soggybag/Trem-SMD/archive/v2.1/README.md

# Trem SMD v2.1: archived revision

- **Git tag:** `v2.1` (commit `e5894ea`, 2026-10-18)
- **Tag note:** v2.1: symmetric VCA balance trim (RV4 3314J 2k), fab files generated 2026-10-18
- **Archived:** 2026-10-18 with `_tools/archive_version.py`

## Finding a part

1. Open `Trem_23_ibom.html` in a browser. Type a reference (R14) or a value (100k) in the filter box; the part lights up on the board.
   - Hover over a pad to see its net.
   - F / B switch sides.
2. Find the same reference in `Trem_23_schematic.pdf` with Cmd-F.
3. `Trem_23_board_front.pdf` / `_back.pdf` are printable: page 1 has the outlines and references, page 2 the copper. The back is mirrored, as you see it holding the board.

## Files

- `Trem_23_board_back.pdf`
- `Trem_23_board_front.pdf`
- `Trem_23_ibom.html`
- `Trem_23_render_bottom.png`
- `Trem_23_render_top.png`
- `Trem_23_schematic.pdf`
- `docs`/
- `parts.csv`
- `production`/

`production/` holds the files sent to JLCPCB for this revision: Trem_23.zip, Trem_23_hand_solder.csv, bom.csv, designators.csv, netlist.ipc, positions.csv.
