soggybag/Trem-SMD/Trem_23_render_bottom.png

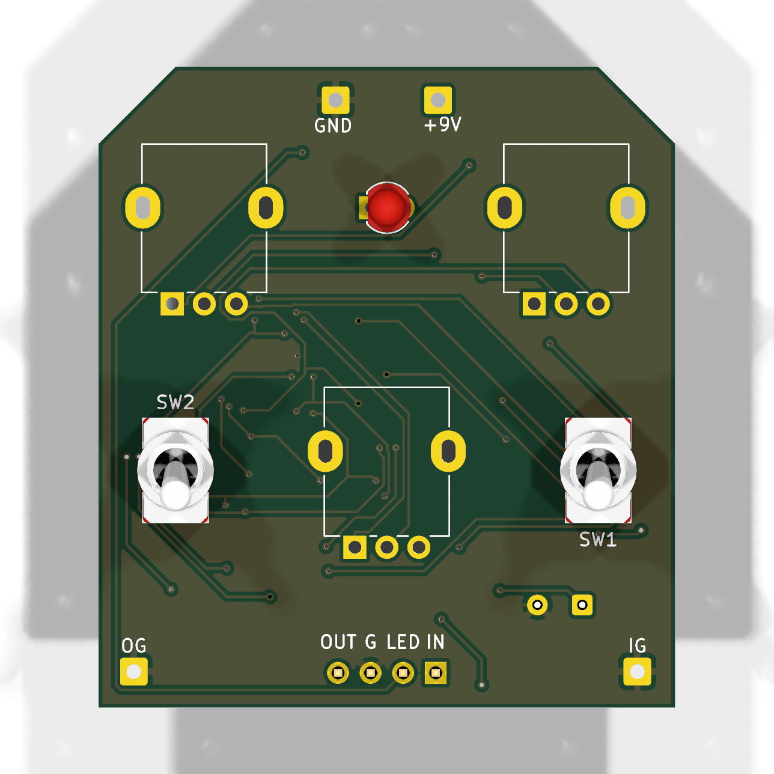
Trem_23_render_bottom.png
