soggybag/Trem-SMD/Trem_23_render_enclosure.png

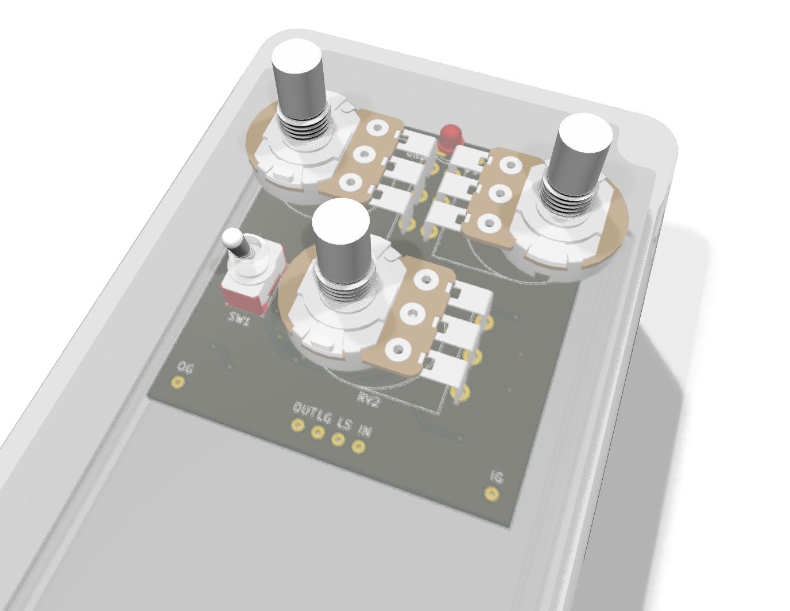
Trem_23_render_enclosure.png
