soggybag/Trem-SMD/Trem_23_render_enclosure_side.png

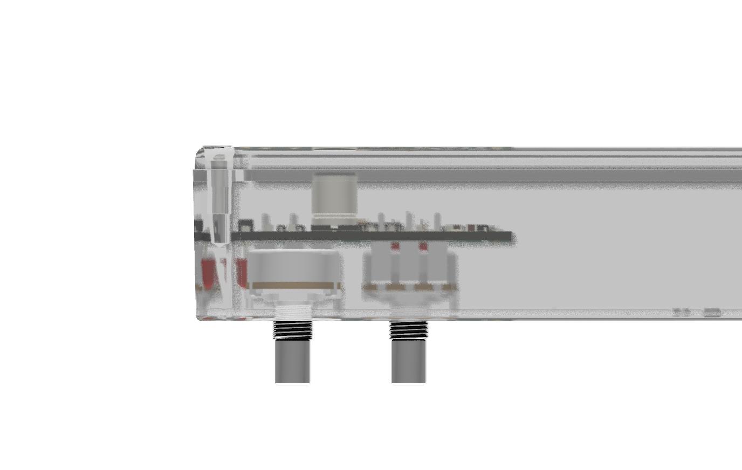
Trem_23_render_enclosure_side.png
