soggybag/Trem-SMD/Trem_23_render_side.png

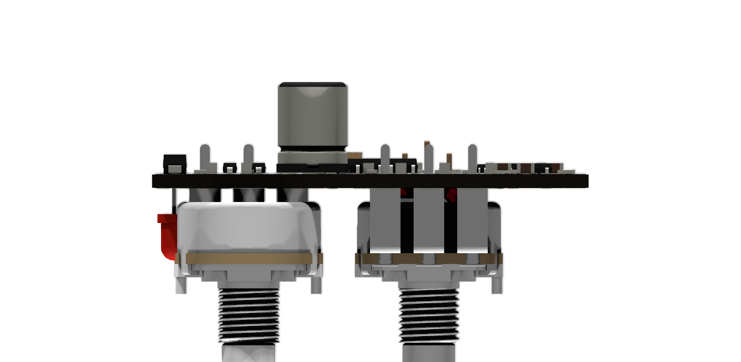
Trem_23_render_side.png
