soggybag/Trem-SMD/archive/v2.1/parts.csv

Reference | Value | Footprint | Side | X mm | Y mm | Rotation | LCSC | Fitted by
C1 | 10u | Capacitor_SMD:C_0805_2012Metric | front | 31.3 | 26.8 | 180.0 | C15850 | JLC
C2 | 100n | Capacitor_SMD:C_0805_2012Metric | front | 36.8 | 47.0 | 0.0 | C49678 | JLC
C3 | 470u | Capacitor_THT:CP_Radial_D8.0mm_P3.50mm | front | 28.25 | 62.0 | 0.0 | C970706 | hand
C4 | 100n | Capacitor_SMD:C_0805_2012Metric | front | 36.9 | 53.5 | 180.0 | C49678 | JLC
C5 | 10u | Capacitor_SMD:C_0805_2012Metric | front | 28.2 | 30.8 | 180.0 | C15850 | JLC
C6 | 10n | Capacitor_SMD:C_0805_2012Metric | front | 53.6 | 40.85 | 180.0 | C1710 | JLC
C7 | 1n | Capacitor_SMD:C_0805_2012Metric | front | 52.15 | 50.3 | 0.0 | C46653 | JLC
C8 | 220p | Capacitor_SMD:C_0805_2012Metric | front | 36.85 | 44.8 | 0.0 | C107145 | JLC
C9 | 1u | Capacitor_SMD:C_0805_2012Metric | front | 39.1 | 64.35 | 180.0 | C28323 | JLC
C10 | 220p | Capacitor_SMD:C_0805_2012Metric | front | 23.7 | 62.8 | -90.0 | C107145 | JLC
C11 | 1n | Capacitor_SMD:C_0805_2012Metric | front | 24.06 | 54.02 | -90.0 | C46653 | JLC
C12 | 100n | Capacitor_SMD:C_0805_2012Metric | front | 36.4 | 58.8 | 0.0 | C49678 | JLC
C13 | 100n | Capacitor_SMD:C_0805_2012Metric | front | 43.54 | 60.82 | -90.0 | C49678 | JLC
C14 | 22p | Capacitor_SMD:C_0805_2012Metric | front | 59.25 | 64.5 | 180.0 | C1804 | JLC
C15 | 1u | Capacitor_SMD:C_0805_2012Metric | front | 61.36 | 57.95 | 90.0 | C28323 | JLC
C16 | 4n7 | Capacitor_SMD:C_0805_2012Metric | front | 43.8 | 64.3 | 0.0 | C1744 | JLC
C17 | 470n | Capacitor_SMD:C_0805_2012Metric_Pad1.18x1.45mm_HandSolder | front | 56.25 | 48.2 | 0.0 | C13967 | JLC
C18 | 33n | Capacitor_SMD:C_0805_2012Metric_Pad1.18x1.45mm_HandSolder | front | 56.05 | 50.55 | 0.0 | C1739 | JLC
C19 | 10n | Capacitor_SMD:C_0805_2012Metric_Pad1.18x1.45mm_HandSolder | front | 33.1 | 47.3 | 0.0 | C1710 | JLC
C20 | 100n | Capacitor_SMD:C_0805_2012Metric_Pad1.18x1.45mm_HandSolder | front | 44.49 | 51.01 | 0.0 | C49678 | JLC
D1 | SS14 | Diode_SMD:D_SMA | front | 32.3 | 22.6 | 180.0 | C2480 | JLC
D2 | LED | LED_THT:LED_D3.0mm | back | 44.77 | 31.0 | 180.0 |  | hand
D3 | 1N4148W | Diode_SMD:D_SOD-123 | front | 34.97 | 34.36 | 0.0 | C81598 | JLC
D4 | 1N4148W | Diode_SMD:D_SOD-123 | front | 42.36 | 27.35 | 180.0 | C81598 | JLC
J1 | +9V | Connector_Wire:SolderWire-0.5sqmm_1x01_D0.9mm_OD2.1mm | front | 39.5 | 22.6 | 0.0 |  | hand
J2 | GND | Connector_Wire:SolderWire-0.5sqmm_1x01_D0.9mm_OD2.1mm | front | 47.5 | 22.6 | 0.0 |  | hand
J4 | IN GND | Connector_Wire:SolderWire-0.5sqmm_1x01_D0.9mm_OD2.1mm | front | 23.95 | 67.2 | 0.0 |  | hand
J6 | OUT GND | Connector_Wire:SolderWire-0.5sqmm_1x01_D0.9mm_OD2.1mm | front | 63.25 | 67.2 | 0.0 |  | hand
J9 | IN/LED/GND/OUT | Connector_PinHeader_2.54mm:PinHeader_1x04_P2.54mm_Vertical | front | 39.69 | 67.3 | 90.0 |  | hand
Q1 | MMBT5089 | Package_TO_SOT_SMD:SOT-23 | front | 31.39 | 55.84 | 0.0 | C116160 | JLC
Q2 | MBT3904DW1 | Package_TO_SOT_SMD:SOT-363_SC-70-6 | front | 50.07 | 45.53 | 0.0 | C110150 | JLC
Q3 | MBT3904DW1 | Package_TO_SOT_SMD:SOT-363_SC-70-6 | front | 63.3 | 51.77 | 180.0 | C110150 | JLC
Q4 | MMBT5401 | Package_TO_SOT_SMD:SOT-23 | front | 58.26 | 60.35 | 180.0 | C8326 | JLC
Q5 | MMBT3904 | Package_TO_SOT_SMD:SOT-23 | front | 44.27 | 36.5 | 0.0 | C20526 | JLC
R1 | 100 | Resistor_SMD:R_0805_2012Metric | front | 35.05 | 51.0 | 180.0 | C17408 | JLC
R2 | 100k | Resistor_SMD:R_0805_2012Metric | front | 30.77 | 33.12 | 0.0 | C149504 | JLC
R3 | 100k | Resistor_SMD:R_0805_2012Metric | front | 24.89 | 45.2 | 0.0 | C149504 | JLC
R4 | 1k | Resistor_SMD:R_0805_2012Metric | front | 51.01 | 25.4 | 180.0 | C17513 | JLC
R5 | 6k8 | Resistor_SMD:R_0805_2012Metric | front | 52.23 | 35.85 | 0.0 | C17772 | JLC
R6 | 10k | Resistor_SMD:R_0805_2012Metric | front | 53.41 | 43.2 | 0.0 | C17414 | JLC
R7 | 22k | Resistor_SMD:R_0805_2012Metric | front | 53.8 | 45.6 | 0.0 | C17560 | JLC
R8 | 68k | Resistor_SMD:R_0805_2012Metric | front | 52.39 | 47.85 | 180.0 | C17801 | JLC
R9 | 2k2 | Resistor_SMD:R_0805_2012Metric | front | 38.0 | 26.1 | 0.0 | C17520 | JLC
R10 | 100k | Resistor_SMD:R_0805_2012Metric | front | 59.85 | 46.65 | 0.0 | C149504 | JLC
R11 | 100k | Resistor_SMD:R_0805_2012Metric | front | 38.6 | 35.59 | -90.0 | C149504 | JLC
R12 | 100k | Resistor_SMD:R_0805_2012Metric | front | 36.9 | 42.0 | 180.0 | C149504 | JLC
R13 | 220k | Resistor_SMD:R_0805_2012Metric | front | 39.01 | 39.2 | 180.0 | C17556 | JLC
R14 | 8k2 | Resistor_SMD:R_0805_2012Metric | front | 42.0 | 53.89 | -90.0 | C17828 | JLC
R15 | 1M | Resistor_SMD:R_0805_2012Metric | front | 36.22 | 64.54 | 90.0 | C17514 | JLC
R16 | 2k2 | Resistor_SMD:R_0805_2012Metric | front | 30.64 | 67.55 | 180.0 | C17520 | JLC
R17 | 2M2 | Resistor_SMD:R_0805_2012Metric | front | 29.8 | 51.99 | 90.0 | C26113 | JLC
R18 | 4k7 | Resistor_SMD:R_0805_2012Metric | front | 36.5 | 61.75 | 0.0 | C17673 | JLC
R19 | 4k7 | Resistor_SMD:R_0805_2012Metric | front | 39.24 | 61.19 | 90.0 | C17673 | JLC
R20 | 200 | Resistor_SMD:R_0805_2012Metric | front | 34.24 | 67.39 | 180.0 | C17540 | JLC
R21 | 47k | Resistor_SMD:R_0805_2012Metric | front | 41.3 | 60.5 | 90.0 | C17713 | JLC
R22 | 1k | Resistor_SMD:R_0805_2012Metric | front | 45.2 | 54.41 | -90.0 | C17513 | JLC
R23 | 1k | Resistor_SMD:R_0805_2012Metric | front | 49.59 | 53.5 | 180.0 | C17513 | JLC
R24 | 10k | Resistor_SMD:R_0805_2012Metric | front | 63.51 | 54.17 | 180.0 | C17414 | JLC
R25 | 10k | Resistor_SMD:R_0805_2012Metric | front | 62.6 | 48.6 | 90.0 | C17414 | JLC
R26 | 20k | Resistor_SMD:R_0805_2012Metric | front | 55.19 | 53.0 | 180.0 | C4328 | JLC
R27 | 22k | Resistor_SMD:R_0805_2012Metric | front | 46.51 | 61.7 | 180.0 | C17560 | JLC
R28 | 3k3 | Resistor_SMD:R_0805_2012Metric | front | 62.5 | 61.49 | 90.0 | C26010 | JLC
R29 | 20k | Resistor_SMD:R_0805_2012Metric | front | 58.61 | 56.6 | 0.0 | C4328 | JLC
R30 | 47k | Resistor_SMD:R_0805_2012Metric | front | 51.35 | 67.3 | 180.0 | C17713 | JLC
R31 | 10k | Resistor_SMD:R_0805_2012Metric | front | 54.95 | 67.27 | 0.0 | C17414 | JLC
R32 | 47k | Resistor_SMD:R_0805_2012Metric | front | 58.41 | 67.1 | 180.0 | C17713 | JLC
R33 | 2M2 | Resistor_SMD:R_0805_2012Metric_Pad1.20x1.40mm_HandSolder | front | 23.7 | 57.11 | 0.0 | C26113 | JLC
R34 | 47k | Resistor_SMD:R_0805_2012Metric_Pad1.20x1.40mm_HandSolder | front | 33.26 | 41.7 | 0.0 | C17713 | JLC
R35 | 10k | Resistor_SMD:R_0805_2012Metric_Pad1.20x1.40mm_HandSolder | front | 48.27 | 35.75 | 0.0 | C17414 | JLC
RV1 | A10k | Potentiometer_THT:Potentiometer_Alpha_RD901F-40-00D_Single_Vertical | back | 32.0 | 38.5 | 90.0 |  | hand
RV2 | B100k | Potentiometer_THT:Potentiometer_Alpha_RD901F-40-00D_Single_Vertical | back | 46.0 | 57.5 | 90.0 |  | hand
RV3 | B100k | Potentiometer_THT:Potentiometer_Alpha_RD901F-40-00D_Single_Vertical | back | 60.25 | 38.5 | 90.0 |  | hand
RV4 | 2k | Potentiometer_SMD:Potentiometer_Bourns_3314J_Vertical | front | 60.0 | 42.3 | 90.0 | C94513 | JLC
SW1 | SQ/TRI | Trem:SW_Taiway_200_SPDT | back | 27.0 | 51.5 | 180.0 |  | hand
SW2 | LFO/AUDIO | Trem:SW_Taiway_200_SPDT | back | 60.0 | 51.5 | 180.0 |  | hand
U1 | TL064 | Package_SO:SOIC-14_3.9x8.7mm_P1.27mm | front | 44.73 | 43.38 | 0.0 | C402159 | JLC
U2 | CD4053 | Package_SO:SOIC-16_3.9x9.9mm_P1.27mm | front | 52.0 | 60.0 | 0.0 | C6742 | JLC
