soggybag/Trem-SMD/3dmodels/RV16AF-41.step

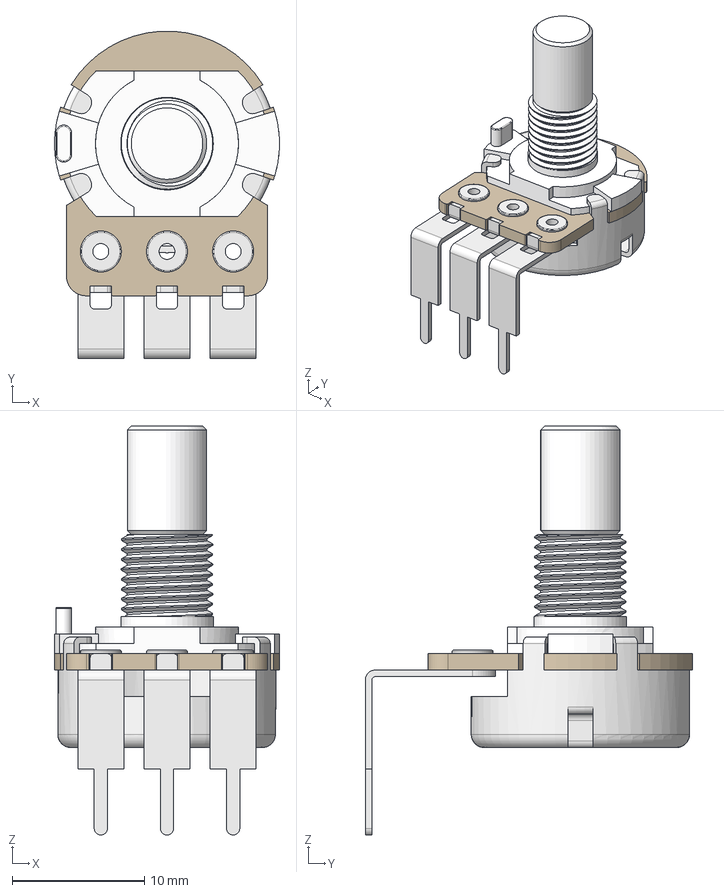
[picture p7: CAD file, 2026-10-03]
3dmodels/RV16AF-41.step
17.0 x 24.7 x 30.9 mm
