soggybag/Trem-SMD/3dmodels/switch_toggle_sub-mini_SPDT_onoff_shortlever.step

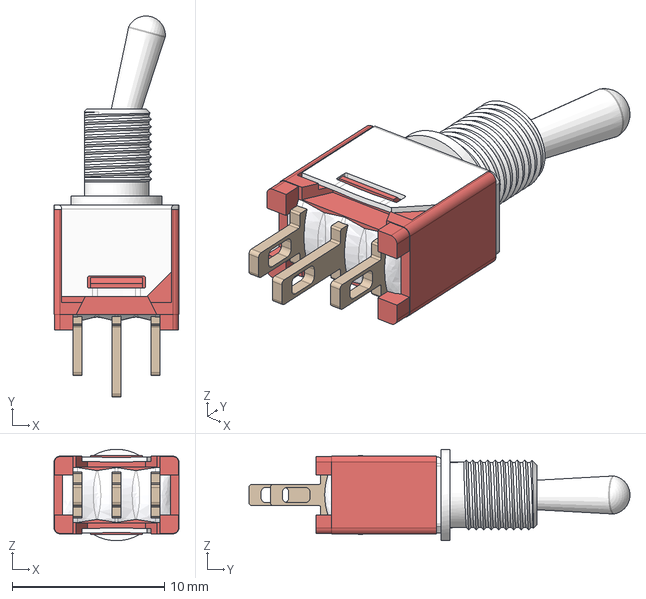
[picture p9: CAD file, 2026-10-03]
3dmodels/switch_toggle_sub-mini_SPDT_onoff_shortlever.step
8.20 x 25.0 x 6.00 mm
