soggybag/Trem-SMD/Trem_23_schematic.pdf

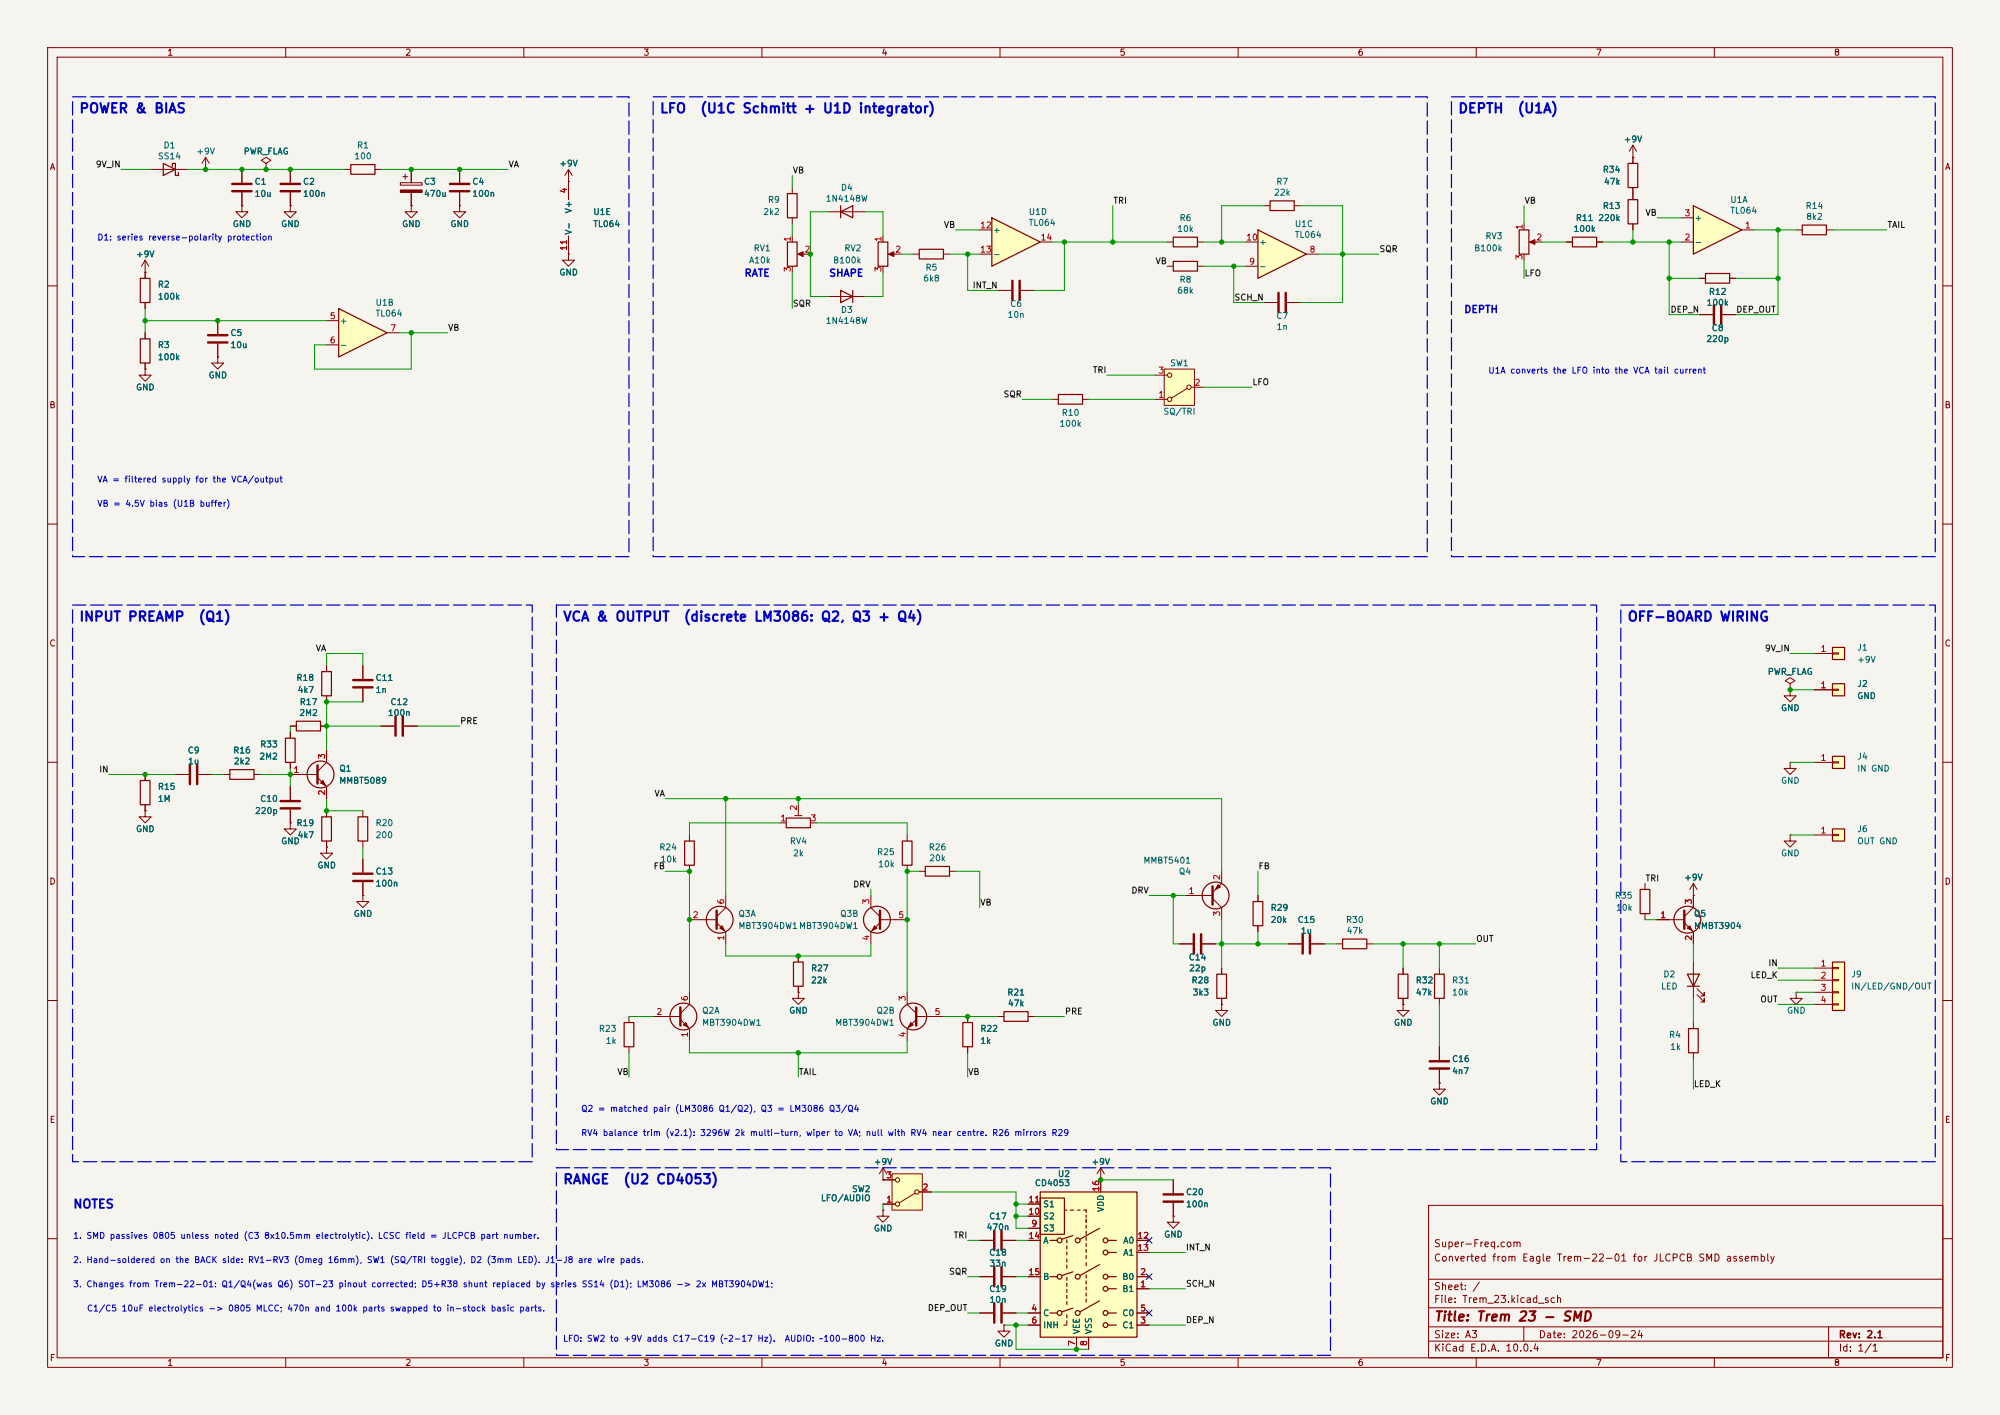
[picture p10: page 1]

D1: series reverse-polarity protection

U1A converts the LFO into the VCA tail current VCA & OUTPUT (discrete LM3086: Q2, Q3 + Q4)

VA = filtered supply for the VCA/output

RV4 balance trim (v2.1): 3296W 2k multi-turn, wiper to VA; null with RV4 near centre. R26 mirrors R29

1. SMD passives 0805 unless noted (C3 8x10.5mm electrolytic). LCSC field = JLCPCB part number.

Super-Freq.com
Converted from Eagle Trem-22-01 for JLCPCB SMD assembly

3. Changes from Trem-22-01: Q1/Q4(was Q6) SOT-23 pinout corrected; D5+R38 shunt replaced by series SS14 (D1); LM3086 -> 2x MBT3904DW1; 2. Hand-soldered on the BACK side: RV1-RV3 (Omeg 16mm), SW1 (SQ/TRI toggle), D2 (3mm LED). J1-J8 are wire pads.

C1/C5 10uF electrolytics -> 0805 MLCC; 470n and 100k parts swapped to in-stock basic parts.

LFO: SW2 to +9V adds C17-C19 (~2-17 Hz). AUDIO: ~100-800 Hz.
