soggybag/Trem-SMD/Trem_23_layout.pdf

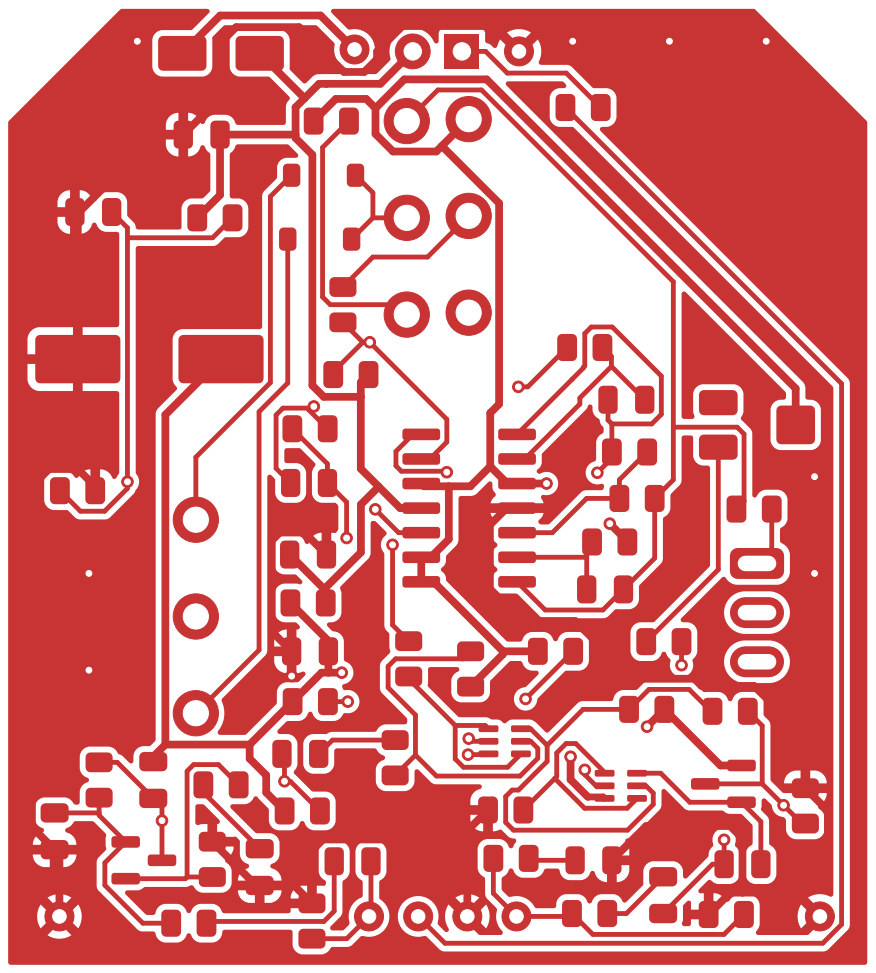
[picture p11: page 1]

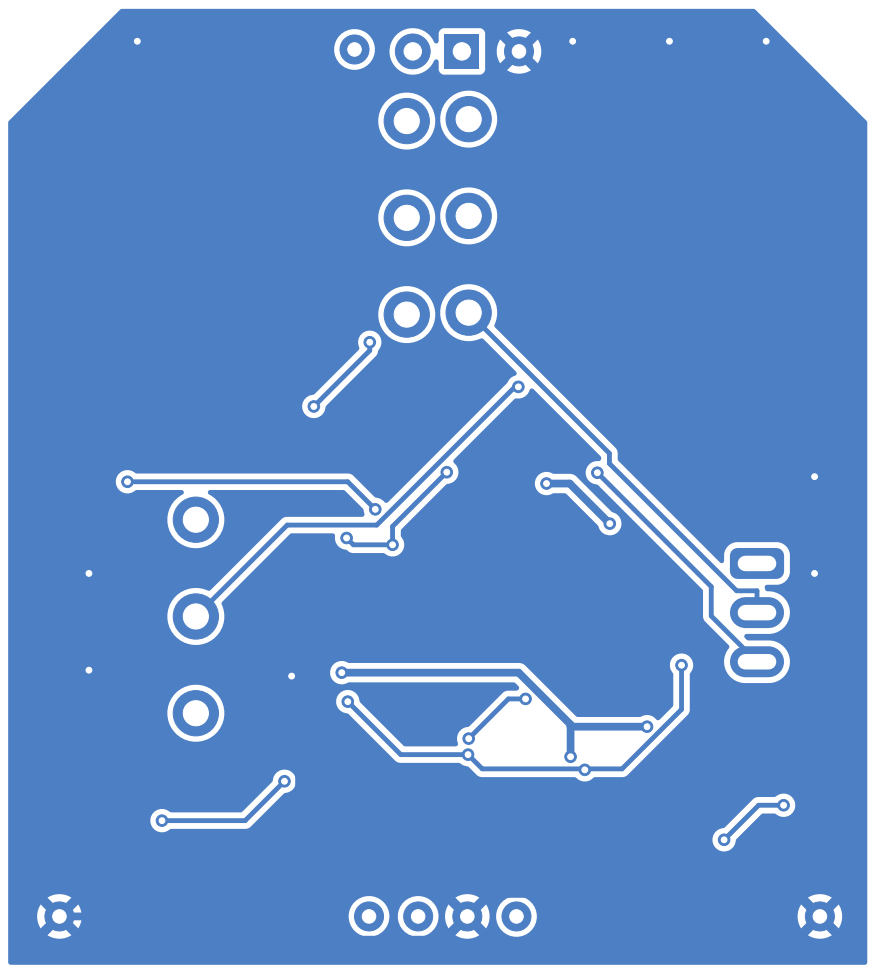
[picture p12: page 2]

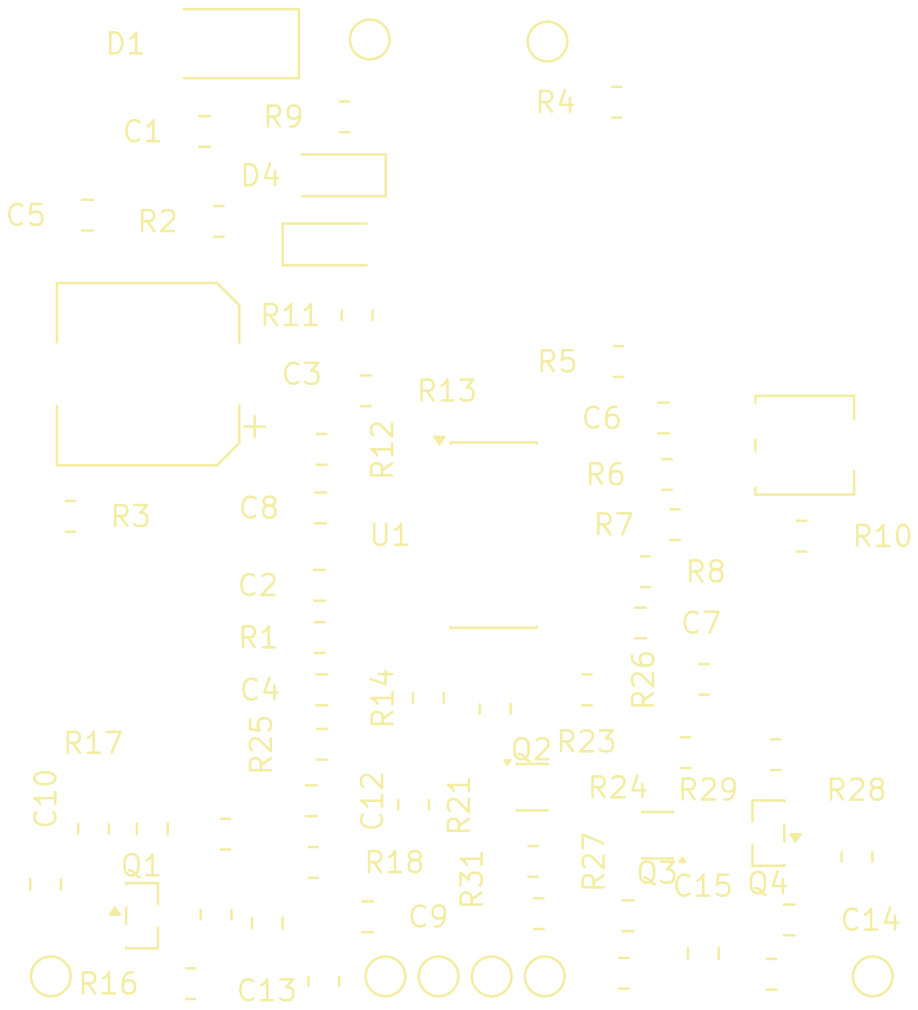
[picture p13: page 3]

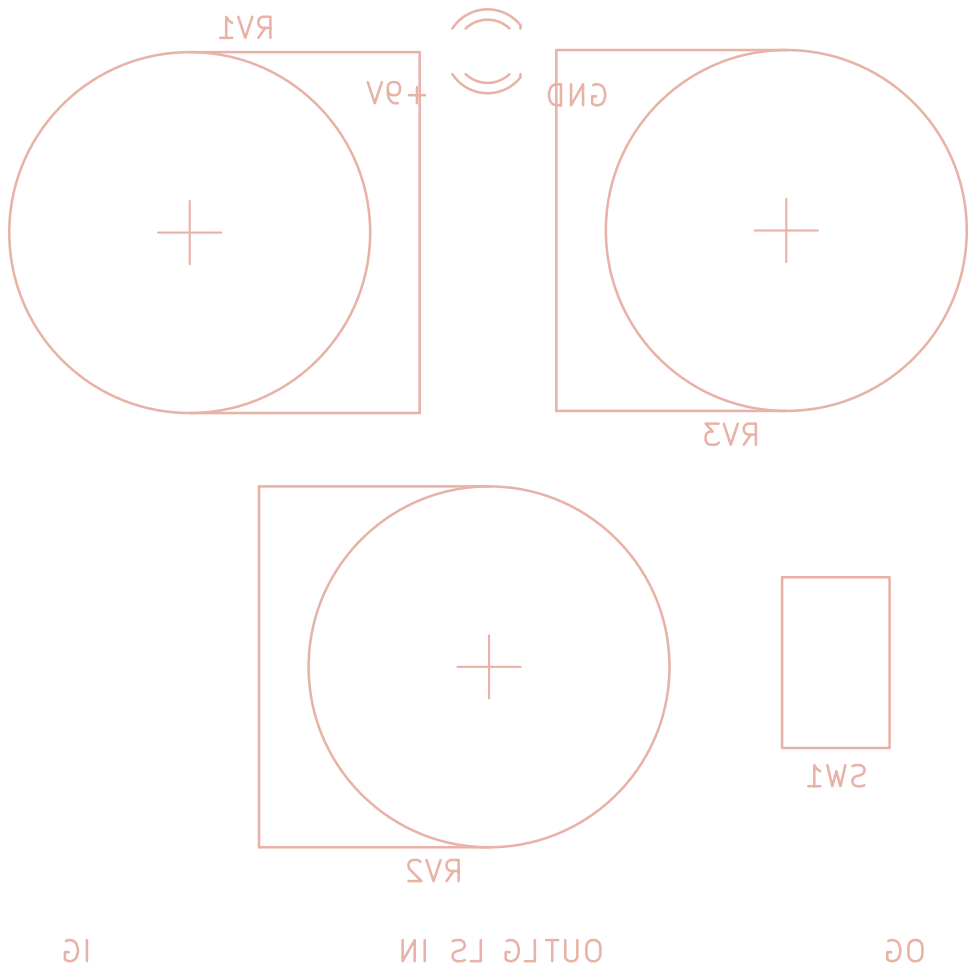
[picture p14: page 4]

IN LS LG OUT GND OG

R32 C11 | R23 R14 | R8 U1

J3 D3

C1 C5 | R7 C7 C16 J7 | C15 C12 | R24 Q2 | R30 J4

J1
R2 | C9
R4 R1 R25 R12 C2 | J6 Q4R21 | R28Q3 R16 | D4
R26 D1 | R22 R17 | R13 R15 C3

# R6 R27 J5

R20 C10 | J8
C6 R3 | R29 C13 | R5 R31 | R10 C4 | RV4
C8 R19 | R11 | J2 Q1 | C14

R9 R18
