soggybag/Trem-SMD/Print.pdf

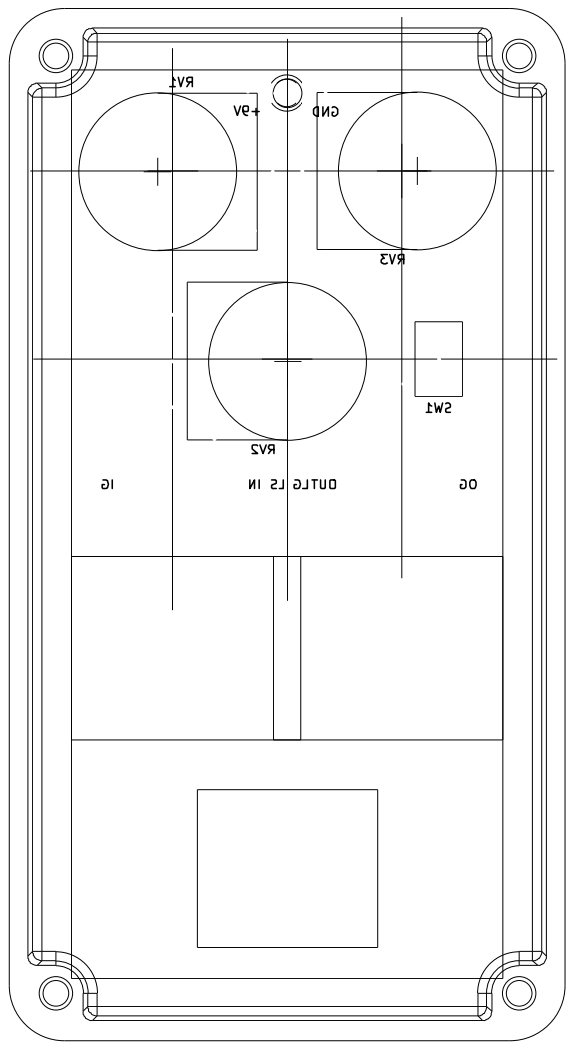
[picture p15: page 1]
