soggybag/Trem-SMD/archive/v2.1/Trem_23_board_back.pdf

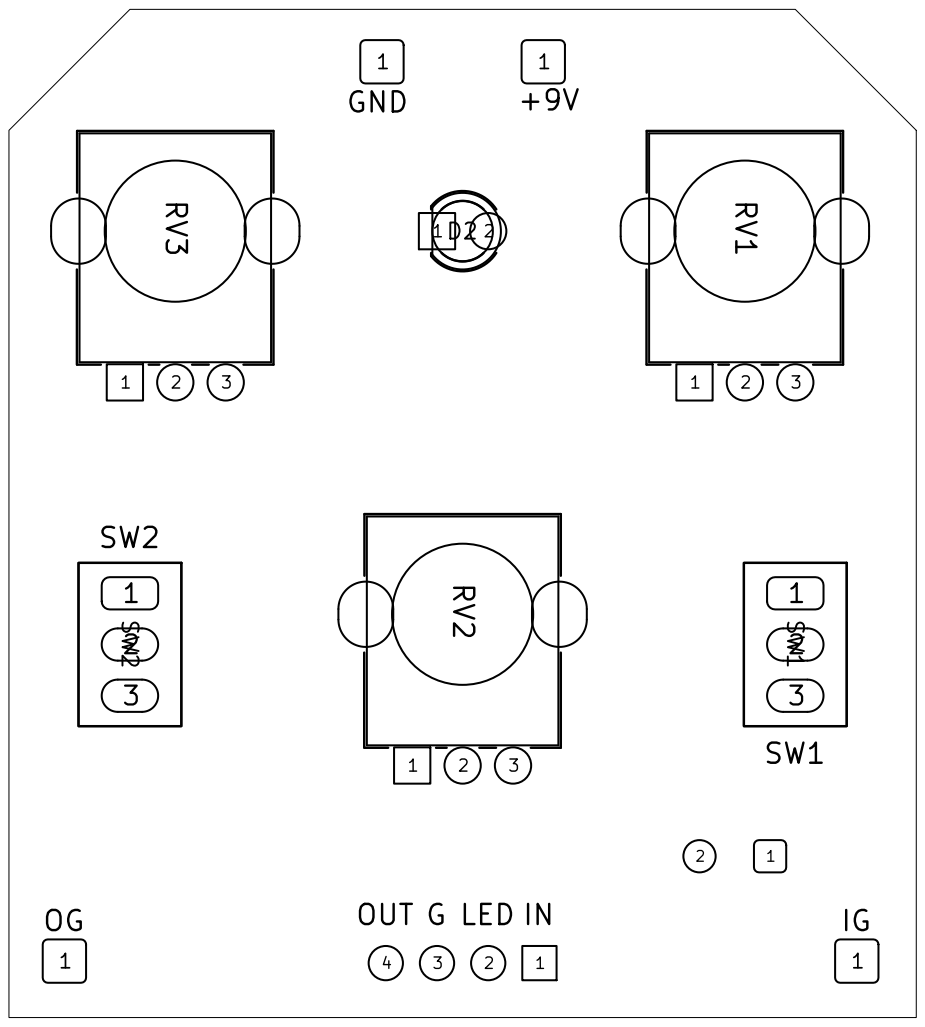
[picture p16: page 1]

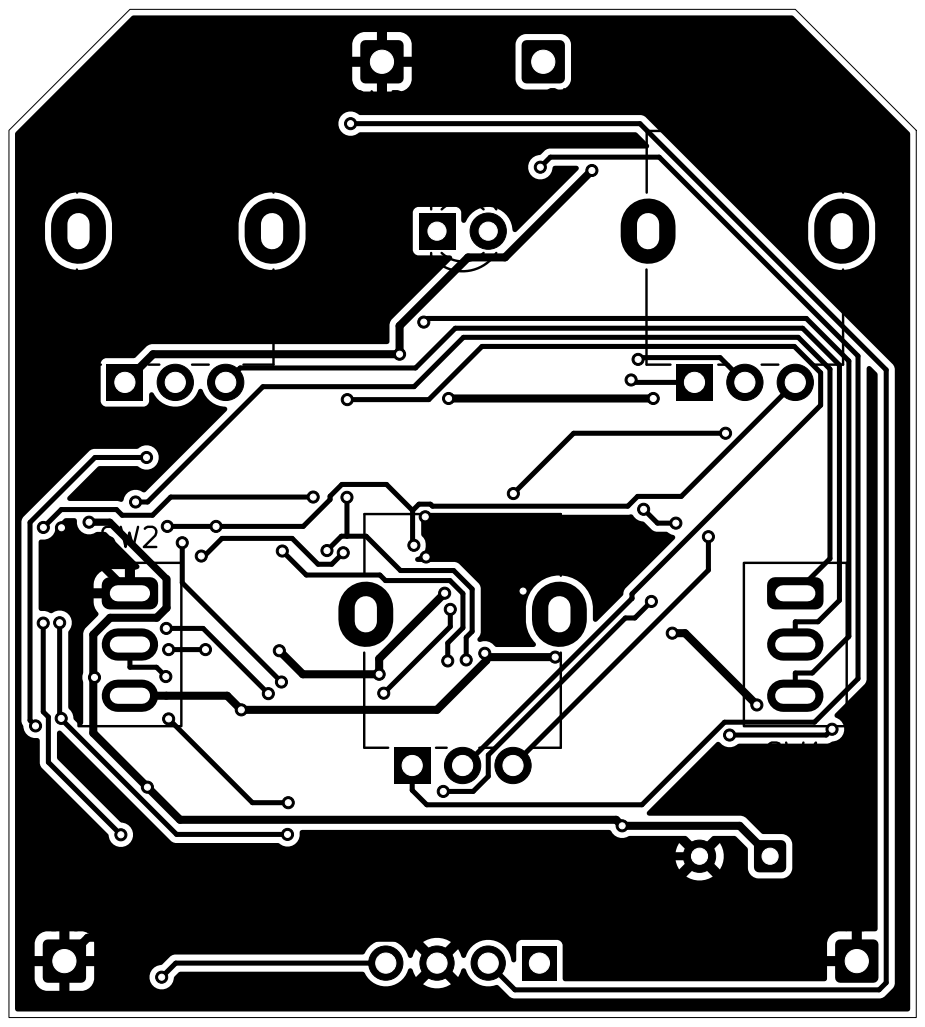
[picture p17: page 2]
