soggybag/Trem-SMD/archive/v2.1/Trem_23_board_front.pdf

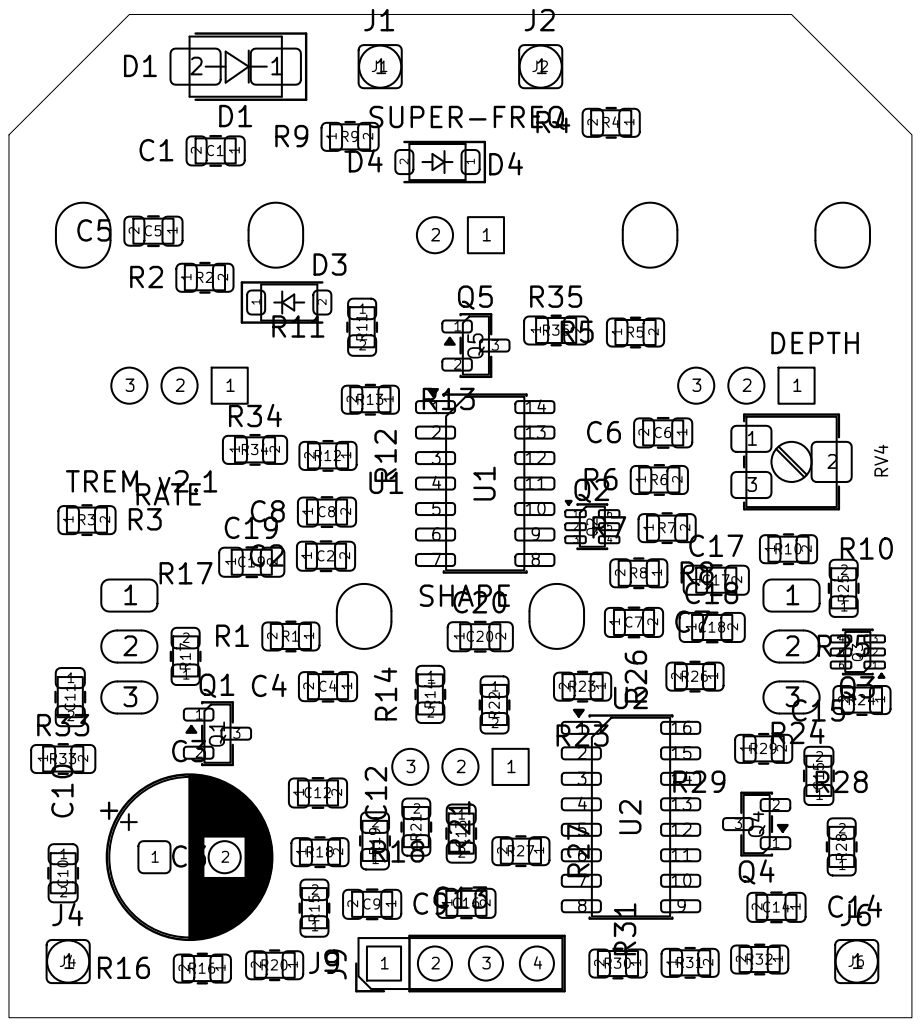
[picture p18: page 1]

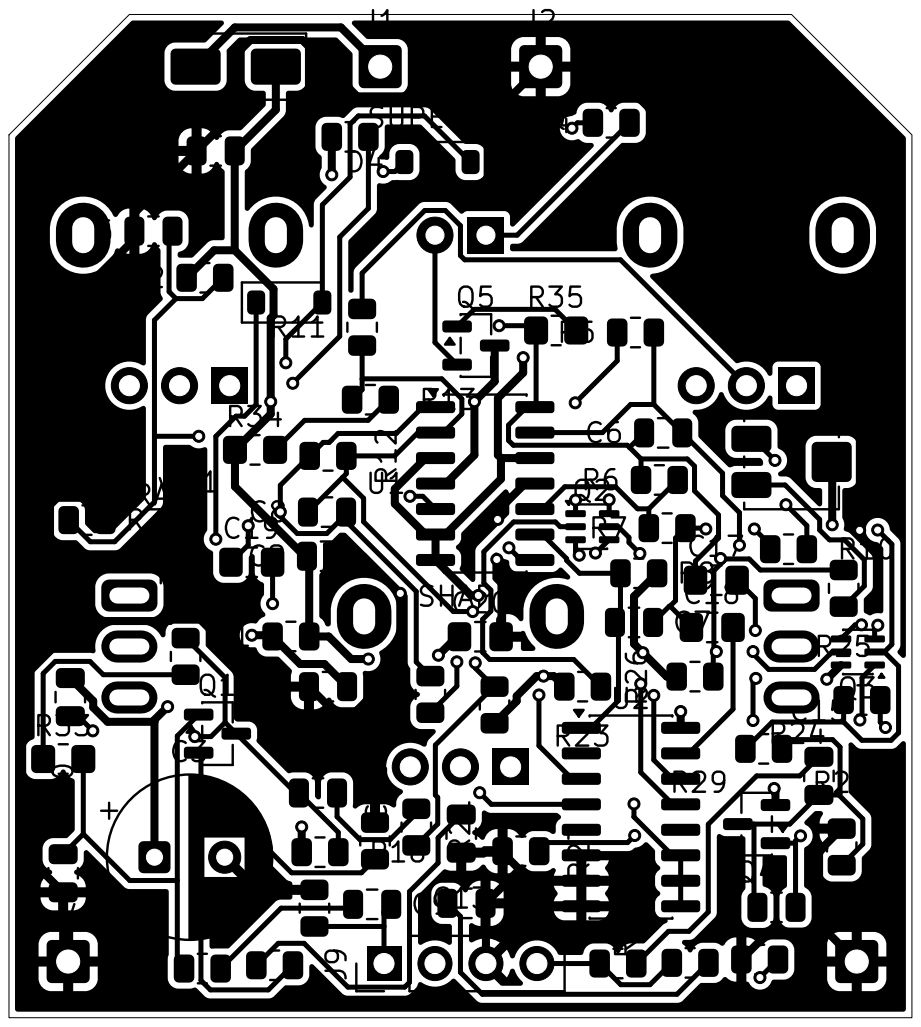
[picture p19: page 2]
