soggybag/Trem-SMD/archive/v1.0/Trem_23_board_back.pdf

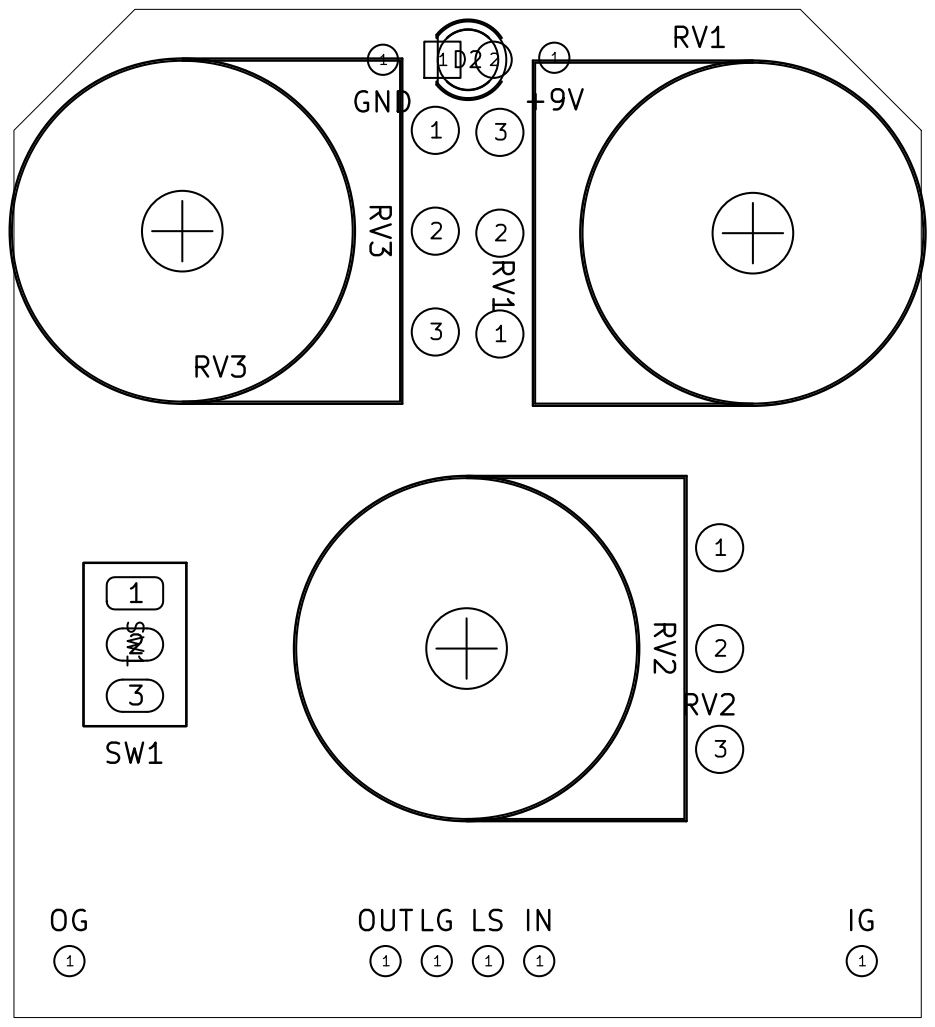
[picture p20: page 1]

OUT LG LS IN

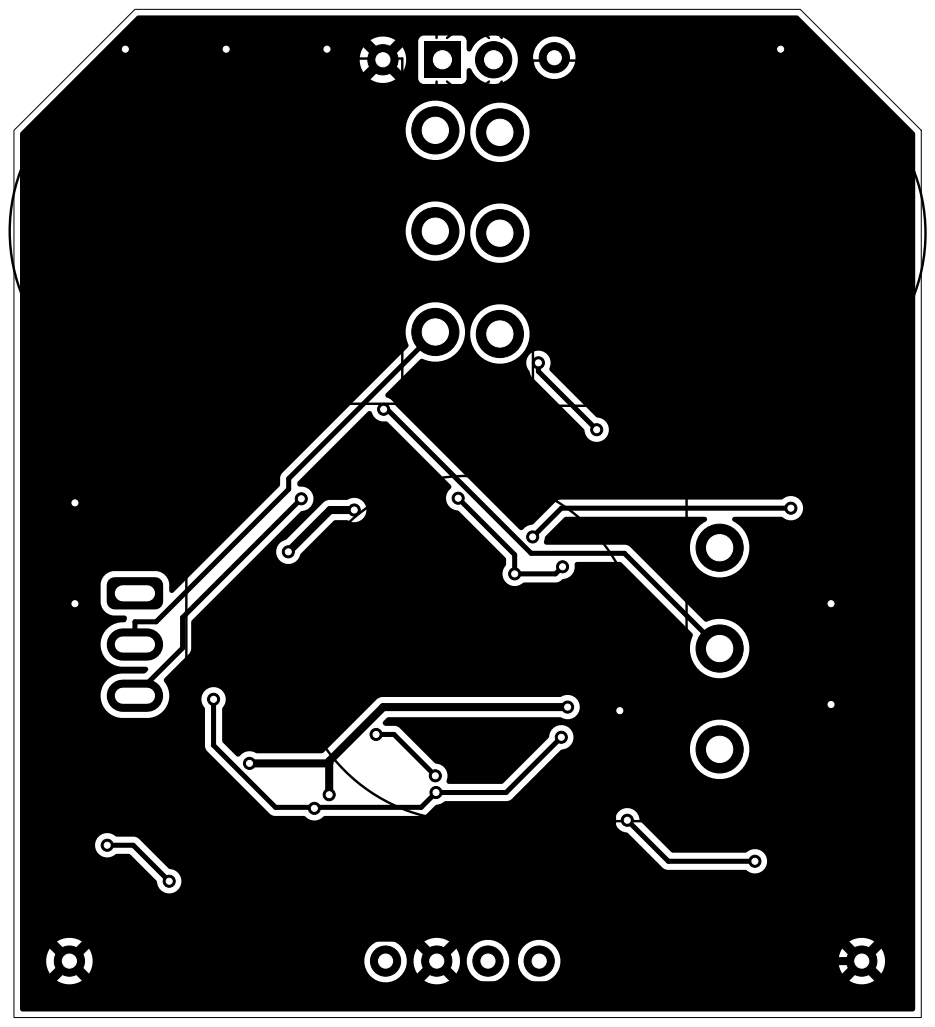
[picture p21: page 2]

OUT LG LS IN
