soggybag/Trem-SMD/archive/v1.0/Trem_23_board_front.pdf

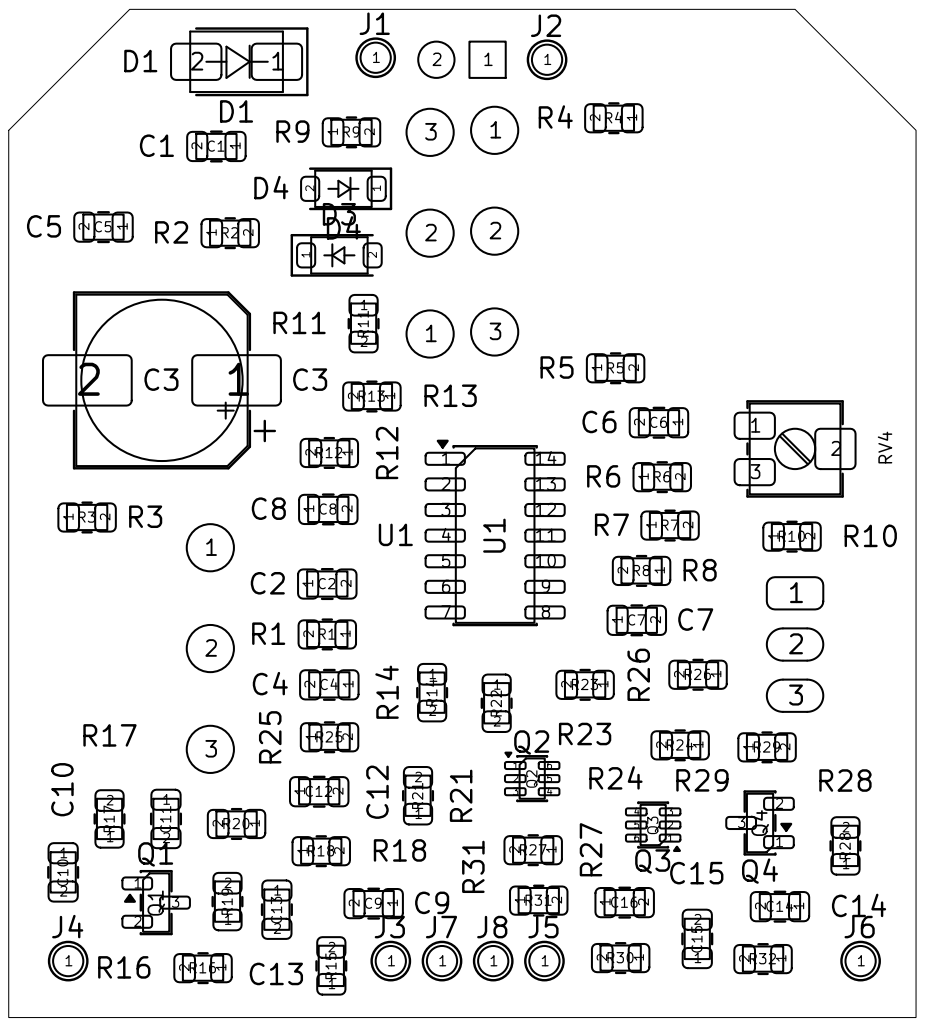
[picture p22: page 1]

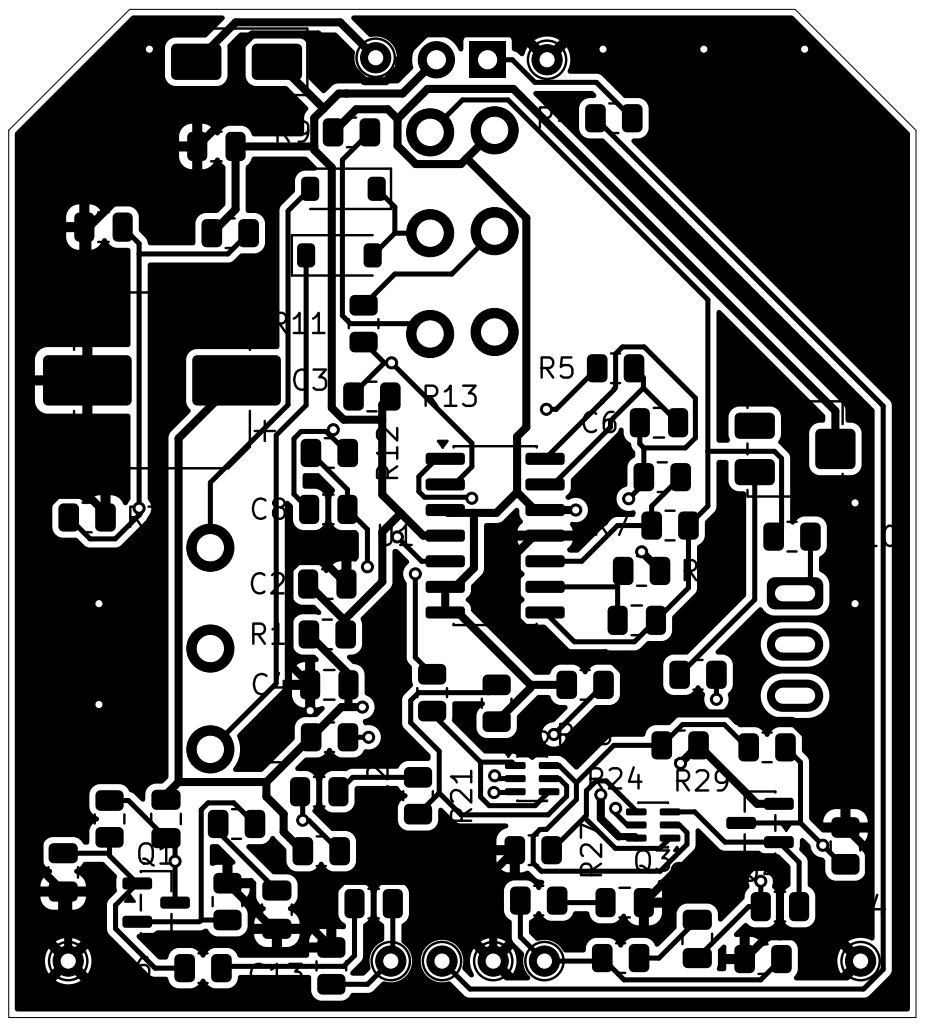
[picture p23: page 2]
