soggybag/Trem-SMD/archive/v2.0/Trem_23_board_back.pdf

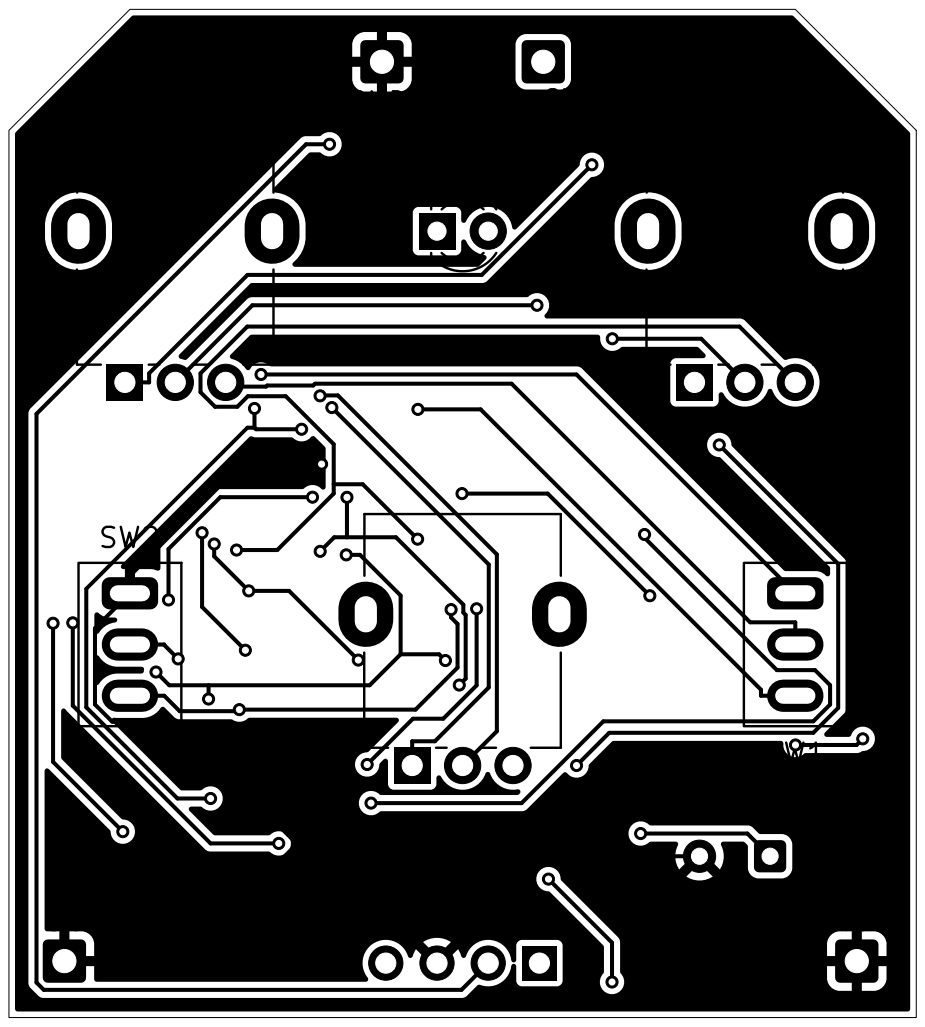
[picture p24: page 2]
