soggybag/Trem-SMD/archive/v2.0/Trem_23_board_front.pdf

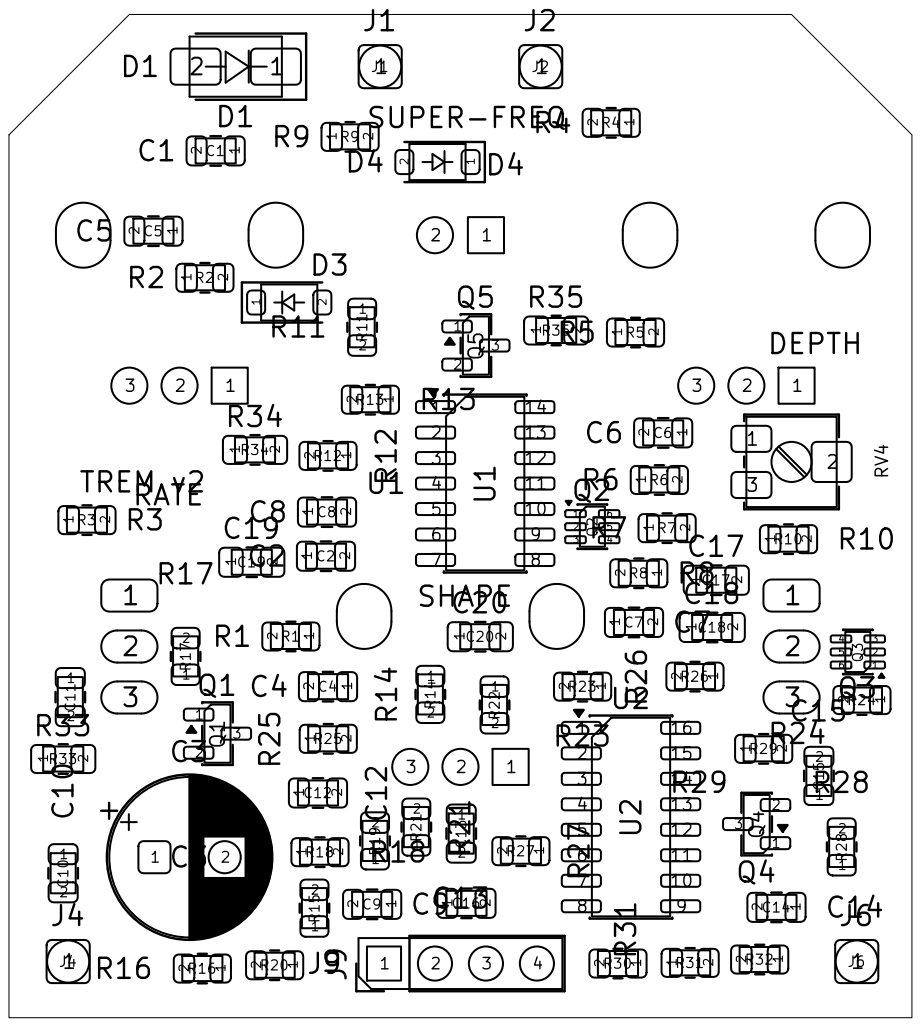
[picture p25: page 1]

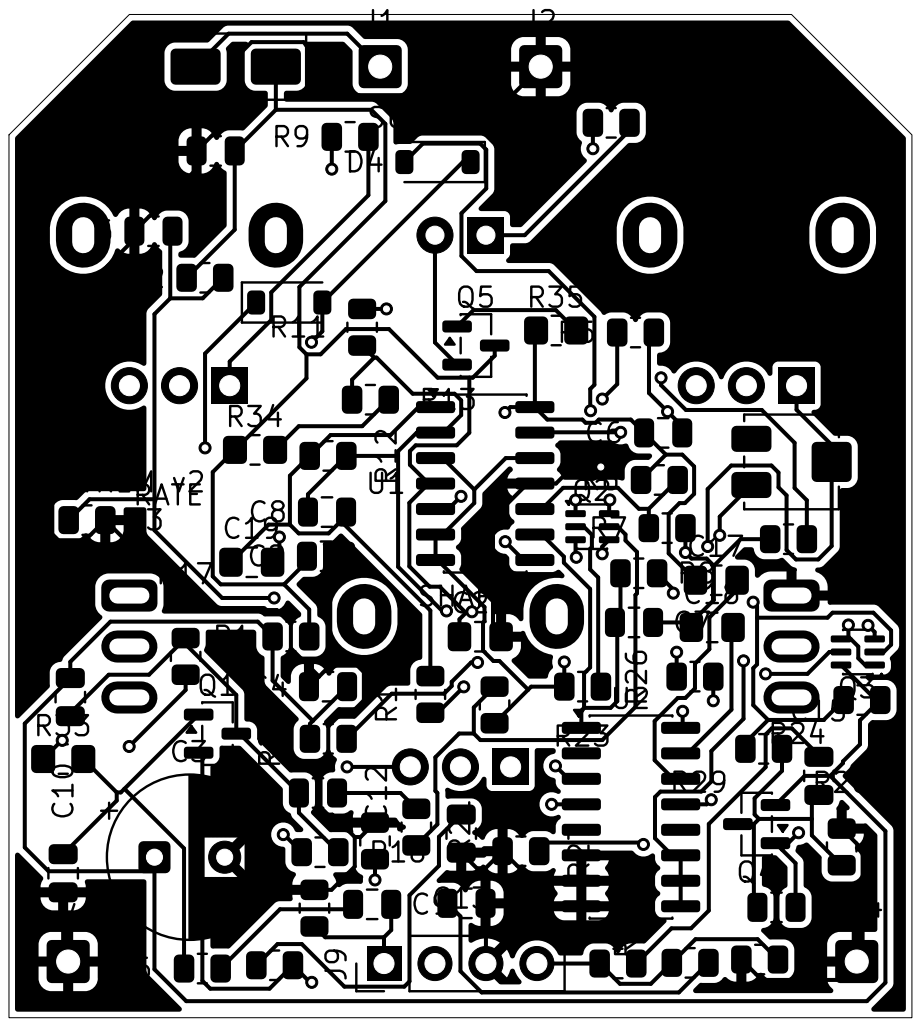
[picture p26: page 2]
