soggybag/Trem-SMD/Trem_23.kicad_pcb

## KiCad design Trem_23.kicad_pcb (2026-10-19)

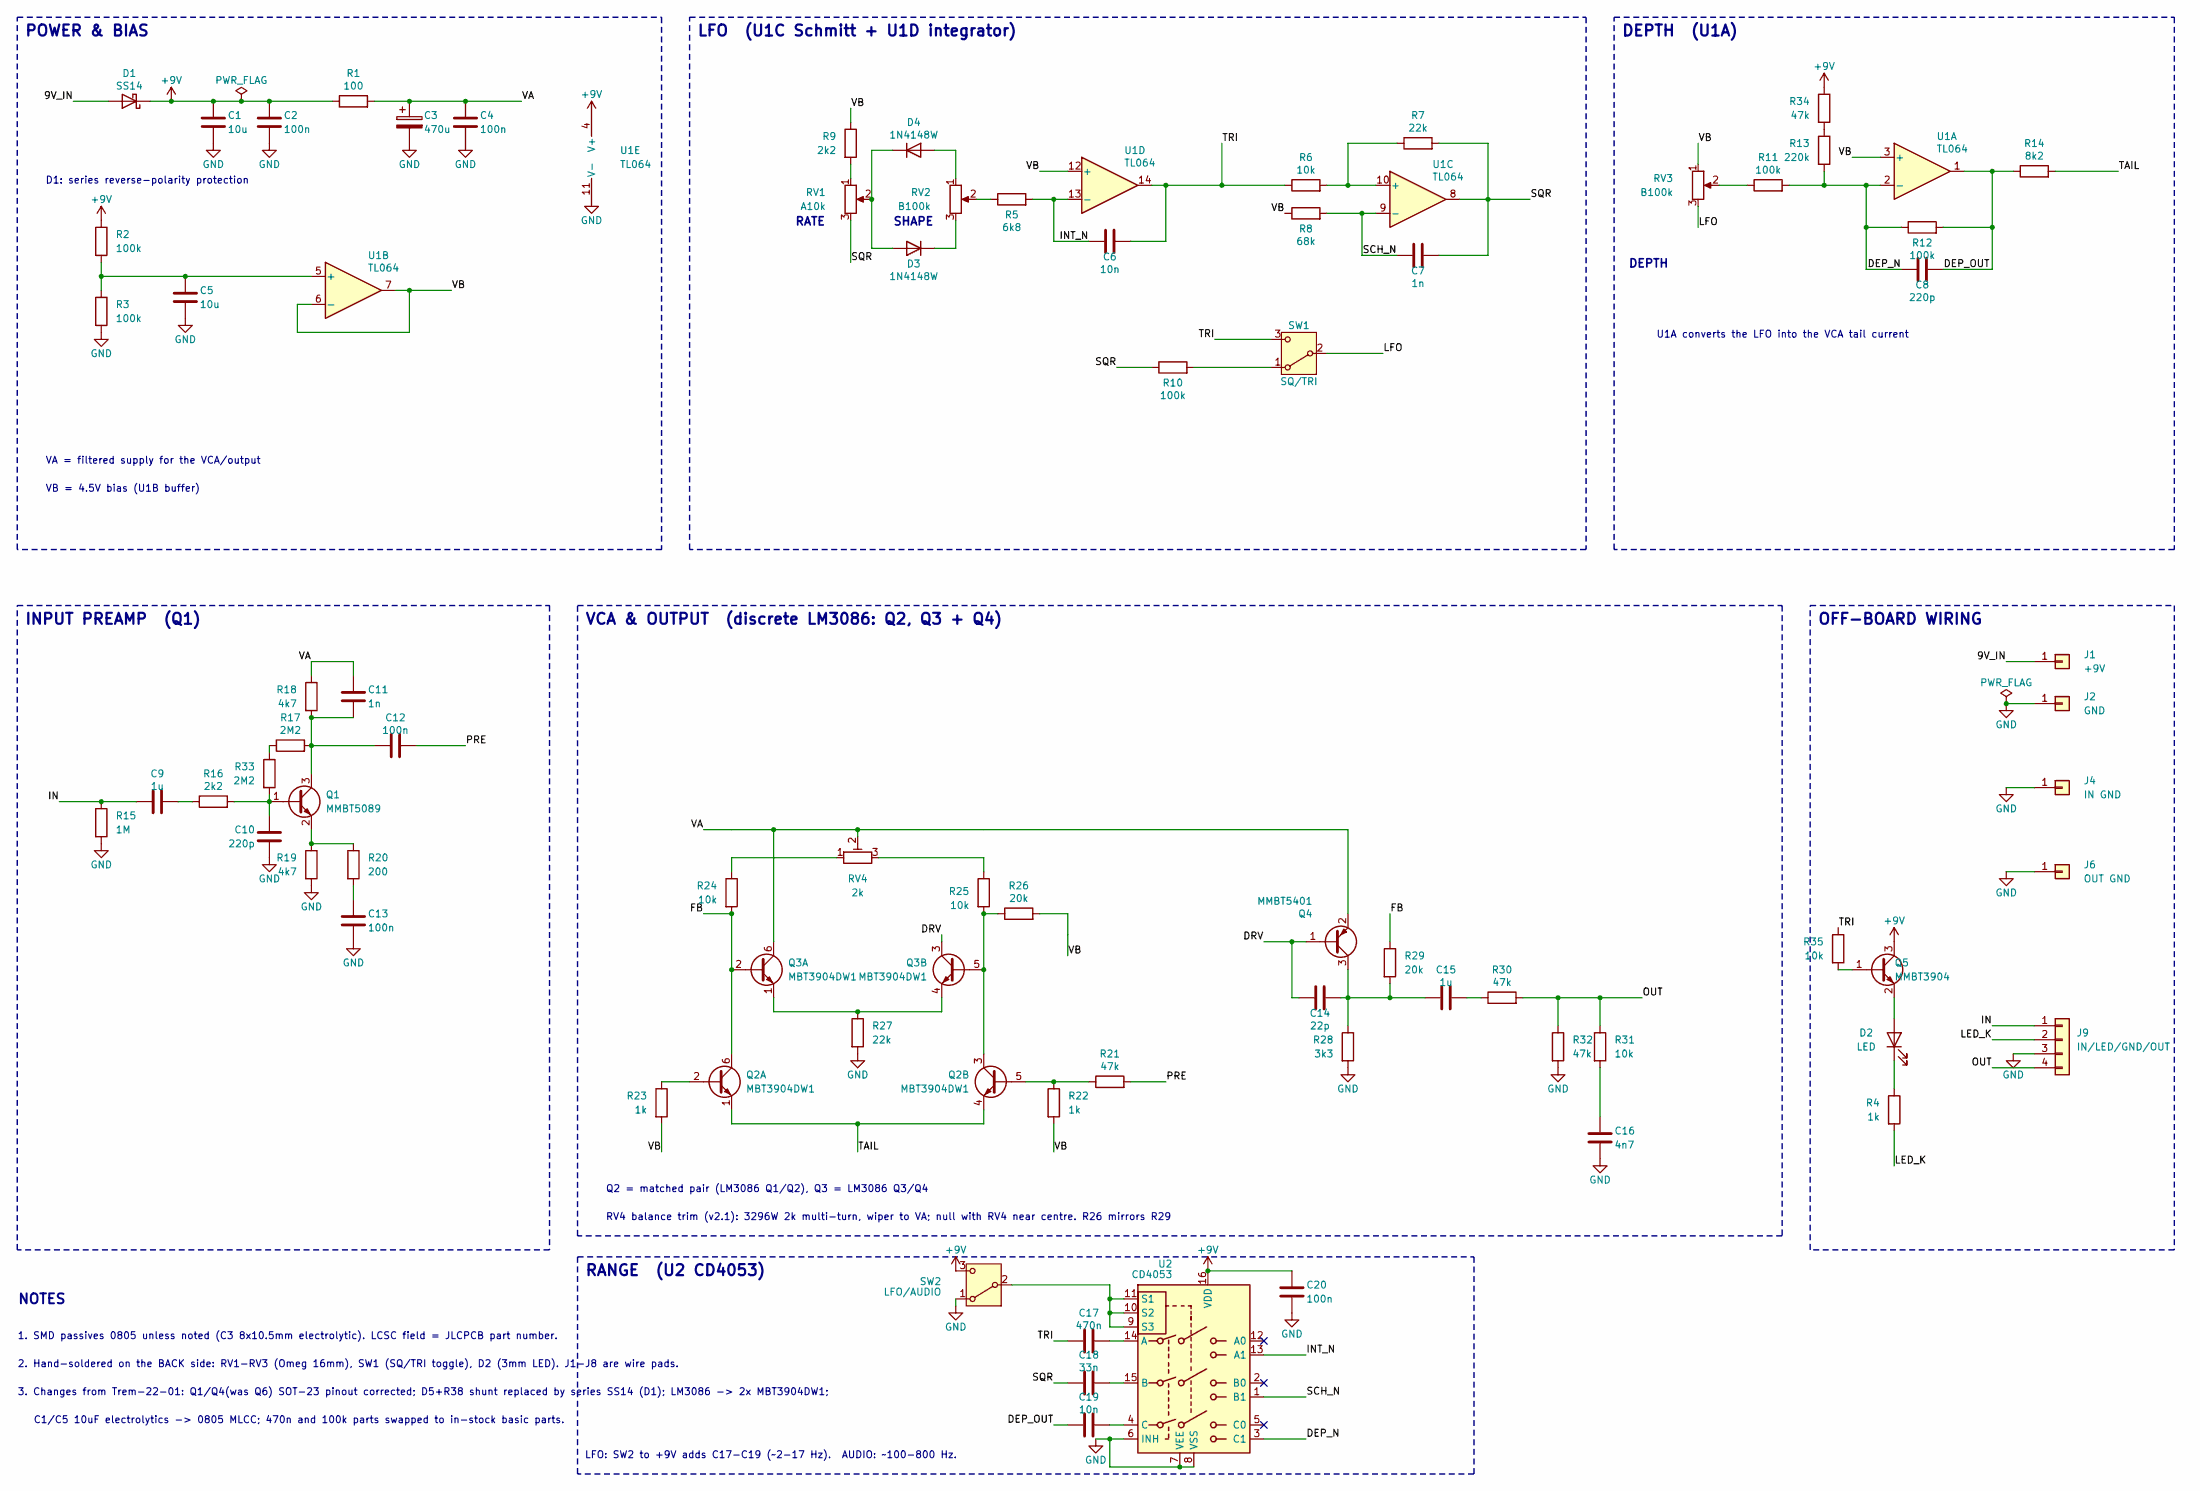
[picture p27: schematic Trem_23.kicad_sch, Trem 23 - SMD]

Parts:
C1, C5: 10u; C_0805_2012Metric; LCSC C15850
C2, C4, C12, C13: 100n; C_0805_2012Metric; LCSC C49678
C3: 470u; CP_Radial_D8.0mm_P3.50mm; LCSC C970706
C6: 10n; C_0805_2012Metric; LCSC C1710
C7, C11: 1n; C_0805_2012Metric; LCSC C46653
C8, C10: 220p; C_0805_2012Metric; LCSC C107145
C9, C15: 1u; C_0805_2012Metric; LCSC C28323
C14: 22p; C_0805_2012Metric; LCSC C1804
C16: 4n7; C_0805_2012Metric; LCSC C1744
C17: 470n; C_0805_2012Metric_Pad1.18x1.45mm_HandSolder; LCSC C13967
C18: 33n; C_0805_2012Metric_Pad1.18x1.45mm_HandSolder; LCSC C1739
C19: 10n; C_0805_2012Metric_Pad1.18x1.45mm_HandSolder; LCSC C1710
C20: 100n; C_0805_2012Metric_Pad1.18x1.45mm_HandSolder; LCSC C49678
D1: SS14; D_SMA; LCSC C2480
D2: LED; LED_D3.0mm
D3, D4: 1N4148W; D_SOD-123; LCSC C81598
J1: +9V; SolderWire-0.5sqmm_1x01_D0.9mm_OD2.1mm
J2: GND; SolderWire-0.5sqmm_1x01_D0.9mm_OD2.1mm
J4: IN GND; SolderWire-0.5sqmm_1x01_D0.9mm_OD2.1mm
J6: OUT GND; SolderWire-0.5sqmm_1x01_D0.9mm_OD2.1mm
J9: IN/LED/GND/OUT; PinHeader_1x04_P2.54mm_Vertical
Q1: MMBT5089; SOT-23; LCSC C116160
Q2, Q3: MBT3904DW1; SOT-363_SC-70-6; LCSC C110150
Q4: MMBT5401; SOT-23; LCSC C8326
Q5: MMBT3904; SOT-23; LCSC C20526
R1: 100; R_0805_2012Metric; LCSC C17408
R2, R3, R10, R11, R12: 100k; R_0805_2012Metric; LCSC C149504
R4, R22, R23: 1k; R_0805_2012Metric; LCSC C17513
R5: 6k8; R_0805_2012Metric; LCSC C17772
R6, R24, R25, R31: 10k; R_0805_2012Metric; LCSC C17414
R7, R27: 22k; R_0805_2012Metric; LCSC C17560
R8: 68k; R_0805_2012Metric; LCSC C17801
R9, R16: 2k2; R_0805_2012Metric; LCSC C17520
R13: 220k; R_0805_2012Metric; LCSC C17556
R14: 8k2; R_0805_2012Metric; LCSC C17828
R15: 1M; R_0805_2012Metric; LCSC C17514
R17: 2M2; R_0805_2012Metric; LCSC C26113
R18, R19: 4k7; R_0805_2012Metric; LCSC C17673
R20: 200; R_0805_2012Metric; LCSC C17540
R21, R30, R32: 47k; R_0805_2012Metric; LCSC C17713
R26, R29: 20k; R_0805_2012Metric; LCSC C4328
R28: 3k3; R_0805_2012Metric; LCSC C26010
R33: 2M2; R_0805_2012Metric_Pad1.20x1.40mm_HandSolder; LCSC C26113
R34: 47k; R_0805_2012Metric_Pad1.20x1.40mm_HandSolder; LCSC C17713
R35: 10k; R_0805_2012Metric_Pad1.20x1.40mm_HandSolder; LCSC C17414
RV1: A10k; Potentiometer_Alpha_RD901F-40-00D_Single_Vertical
RV2, RV3: B100k; Potentiometer_Alpha_RD901F-40-00D_Single_Vertical
RV4: 2k; Potentiometer_Bourns_3314J_Vertical; LCSC C94513
SW1: SQ/TRI; SW_Taiway_200_SPDT
SW2: LFO/AUDIO; SW_Taiway_200_SPDT
U1: TL064; SOIC-14_3.9x8.7mm_P1.27mm; LCSC C402159
U2: CD4053; SOIC-16_3.9x9.9mm_P1.27mm; LCSC C6742

Connections:
/9V_IN: D1.2 (A), J1.1
/DEP_N: C8.1, R11.2, R12.1, R13.2, U1.2 (-), U2.3 (C1)
/DEP_OUT: C8.2, C19.1, R12.2, R14.1, U1.1
/DRV: C14.1, Q3.3 (C2), Q4.1 (B)
/FB: Q2.6 (C1), Q3.2 (B1), R24.2, R29.1
/IN: C9.1, J9.1, R15.1
/INT_N: C6.1, R5.2, U1.13 (-), U2.13 (A1)
/LED_K: J9.2, R4.2
/LFO: RV3.3, SW1.2 (B)
/OUT: J9.4, R30.2, R31.1, R32.1
/PRE: C12.2, R21.2
/SCH_N: C7.1, R8.2, U1.9 (-), U2.1 (B1)
/SQR: C7.2, C18.1, R7.2, R10.1, RV1.3, U1.8
/TAIL: Q2.1 (E1), Q2.4 (E2), R14.2
/TRI: C6.2, C17.1, R6.1, R35.1, SW1.3 (C), U1.14
/VA: C3.1, C4.1, C11.1, Q3.6 (C1), Q4.2 (E), R1.2, R18.1, RV4.2
/VB: R8.1, R9.1, R22.2, R23.2, R26.2, RV3.1, U1.3 (+), U1.6 (-), U1.7, U1.12 (+)
unnamed: C9.2, R16.1
unnamed: C13.1, R20.2
unnamed: C15.2, R30.1
unnamed: C16.1, R31.2
unnamed: D2.2 (A), Q5.2 (E)
unnamed: D2.1 (K), R4.1
unnamed: D3.2 (A), D4.1 (K), RV1.2
unnamed: D3.1 (K), RV2.3
unnamed: D4.2 (A), RV2.1
unnamed: C10.1, Q1.1 (B), R16.2, R33.2
unnamed: C11.2, C12.1, Q1.3 (C), R17.2, R18.2
unnamed: Q1.2 (E), R19.1, R20.1
unnamed: Q2.2 (B1), R23.1
unnamed: Q2.5 (B2), R21.1, R22.1
unnamed: Q2.3 (C2), Q3.5 (B2), R25.2, R26.1
unnamed: Q3.1 (E1), Q3.4 (E2), R27.1
unnamed: C14.2, C15.1, Q4.3 (C), R28.1, R29.2
unnamed: Q5.1 (B), R35.2
unnamed: R5.1, RV2.2
unnamed: R9.2, RV1.1
unnamed: R11.1, RV3.2
unnamed: R13.1, R34.2
unnamed: R17.1, R33.1
unnamed: R24.1, RV4.1
unnamed: R25.1, RV4.3
unnamed: R10.2, SW1.1 (A)
unnamed: SW2.2 (B), U2.9 (S3), U2.10 (S2), U2.11 (S1)
unnamed: C5.1, R2.2, R3.1, U1.5 (+)
unnamed: R6.2, R7.1, U1.10 (+)
unnamed: C17.2, U2.14 (A)
unnamed: C18.2, U2.15 (B)
unnamed: C19.2, U2.4 (C)

Notes on the sheet:
C1/C5 10uF electrolytics -> 0805 MLCC; 470n and 100k parts swapped to in-stock basic parts.
DEPTH
1. SMD passives 0805 unless noted (C3 8x10.5mm electrolytic). LCSC field = JLCPCB part number.
DEPTH (U1A)
U1A converts the LFO into the VCA tail current
LFO (U1C Schmitt + U1D integrator)
OFF-BOARD WIRING
D1: series reverse-polarity protection
VCA & OUTPUT (discrete LM3086: Q2, Q3 + Q4)
POWER & BIAS
NOTES
SHAPE
INPUT PREAMP (Q1)
2. Hand-soldered on the BACK side: RV1-RV3 (Omeg 16mm), SW1 (SQ/TRI toggle), D2 (3mm LED). J1-J8 are wire pads.
Q2 = matched pair (LM3086 Q1/Q2), Q3 = LM3086 Q3/Q4
VA = filtered supply for the VCA/output
RATE
VB = 4.5V bias (U1B buffer)
RV4 balance trim (v2.1): 3296W 2k multi-turn, wiper to VA; null with RV4 near centre. R26 mirrors R29
3. Changes from Trem-22-01: Q1/Q4(was Q6) SOT-23 pinout corrected; D5+R38 shunt replaced by series SS14 (D1); LM3086 -> 2x MBT3904DW1;
RANGE (U2 CD4053)
LFO: SW2 to +9V adds C17-C19 (~2-17 Hz). AUDIO: ~100-800 Hz.

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
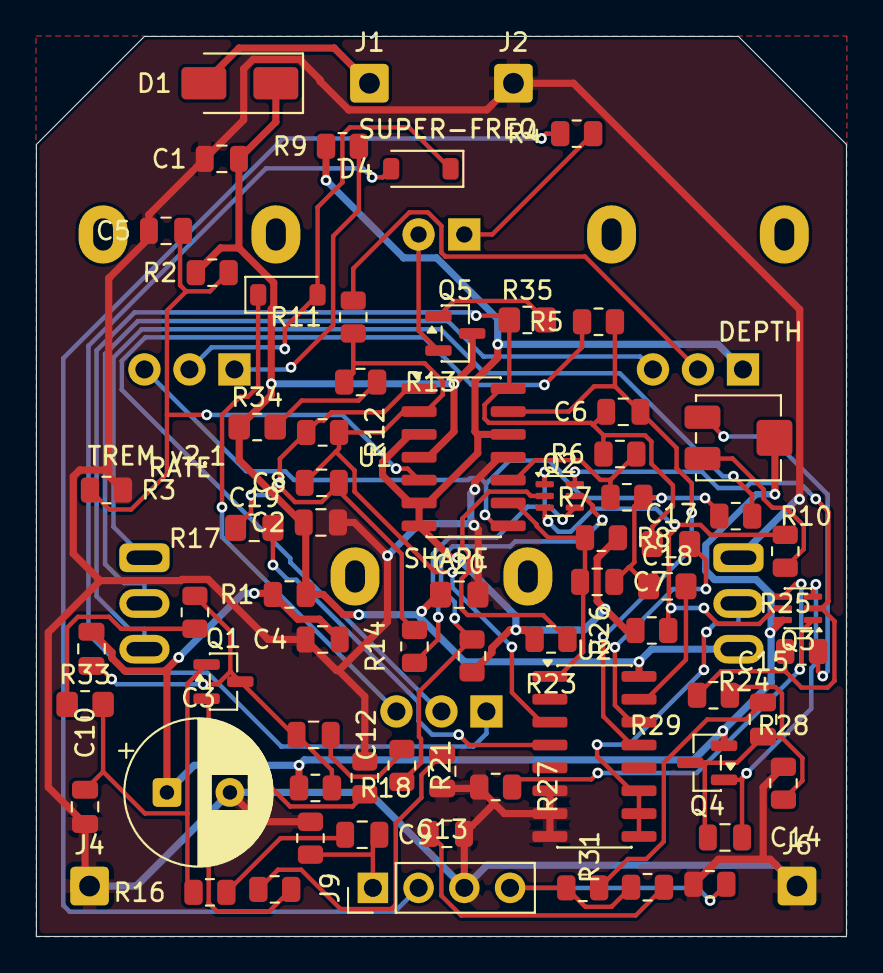
[picture p28: board Trem_23.kicad_pcb from above]

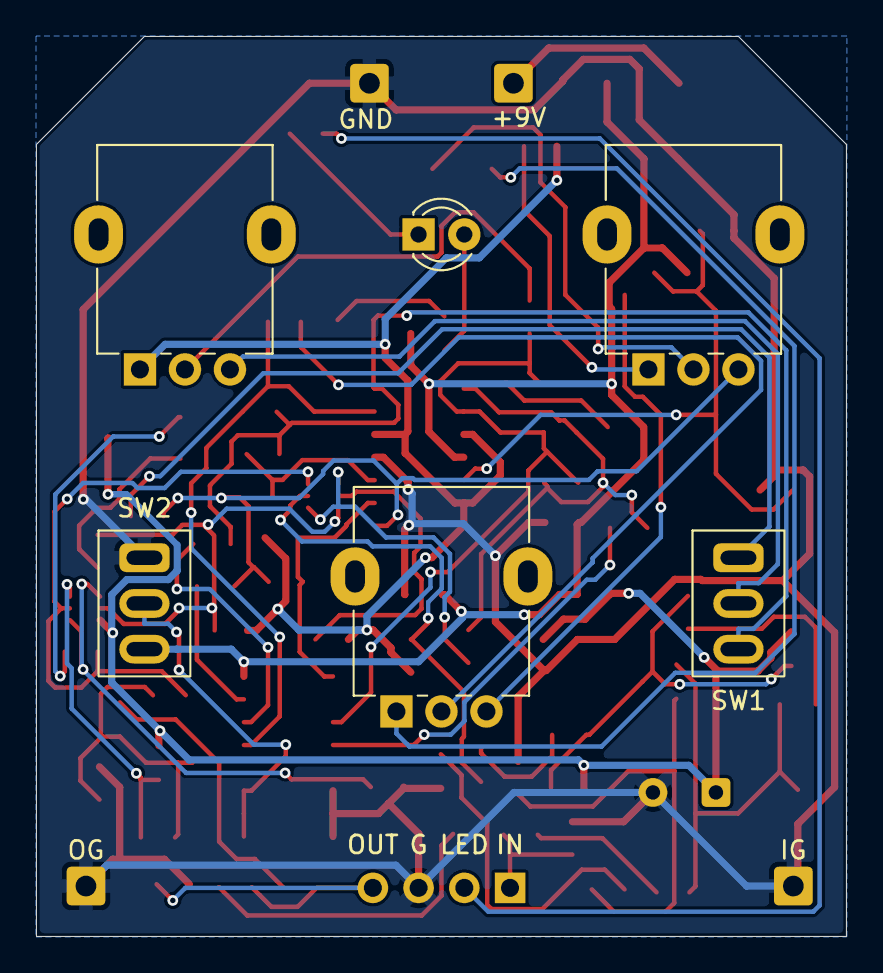
[picture p29: board Trem_23.kicad_pcb from below]

Board: 2 copper layers, 45.0 x 50.0 mm, 78 parts (7 on the bottom side), 51 nets.

Other parts of the board:
ENC1: Hammond 1590B; Hammond_1590B
