soggybag/Trem-SMD/(commit log)

2026-10-03 Trem SMD: KiCad project, docs and bench results
    KiCad 10 project (TL064 LFO + discrete LM3086-style VCA, 1590B) as
    ordered from JLCPCB, with project-local footprints and 3D models,
    schematic/layout PDFs, renders, the bench test procedure and results,
    build notes for the next revision, and a write-up of the reusable VCA.
    [1590B.stp, RV16AF-41.step, Trem_23.kicad_pcb, Trem_23.kicad_sch, switch_toggle_sub-mini_SPDT_onoff_shortlever.step]
2026-10-07 Trem v2.0: 9 mm pots (correct direction), RANGE switch, LFO-rate LED, 1x4 header; Unit #1 build log
    As ordered from JLCPCB 2026-10-04.
    [Trem_1590B_drill.csv, Trem_23.kicad_pcb, Trem_23.kicad_sch, parts.csv, pot_RD901F_T18_shaft_alpha_9mm_vertical.step]
2026-10-07 Archive v1.0 and v2.0: schematic and board PDFs, renders, interactive BOM, parts list, docs and fab files
    [Trem_1590B_drill.csv, Trem_23_BOM_JLCPCB.csv, Trem_23_hand_solder.csv, bom.csv, designators.csv, parts.csv, positions.csv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]
2026-10-13 v2.1 schematic: symmetric VCA balance trim (RV4 3296W 2k, wiper to VA; R26 20k to VB)
    [Trem_23.kicad_sch]
2026-10-19 v2.1 PCB: RV4 back to Bourns 3314J (2k SMD, C94513, JLC-placed) for the symmetric balance trim; full re-route; fab files
    The 3296W THT trimmer left 24 pads unrouted. 3314J at the v2.0 spot routes cleanly:
    0 unconnected, 0 DRC errors, 67 vias.
    [Trem_23.kicad_pcb, Trem_23.kicad_sch]
2026-10-19 Archive v2.1: schematic and board PDFs, renders, interactive BOM, parts list, docs and fab files
    [Trem_1590B_drill.csv, Trem_23_hand_solder.csv, bom.csv, designators.csv, parts.csv, positions.csv]
